BrainOnFire/Wildfire_Detector_Project_Files_Thesis/Wildfire Detector Project PCB Files/Gateway Files/Gateway PCB V1/GatewayPCB.kicad_pcb

## KiCad design Wildfire Detector Project PCB Files/Gateway Files/Gateway PCB V1/GatewayPCB.kicad_pcb (2023-12-11, an earlier design)

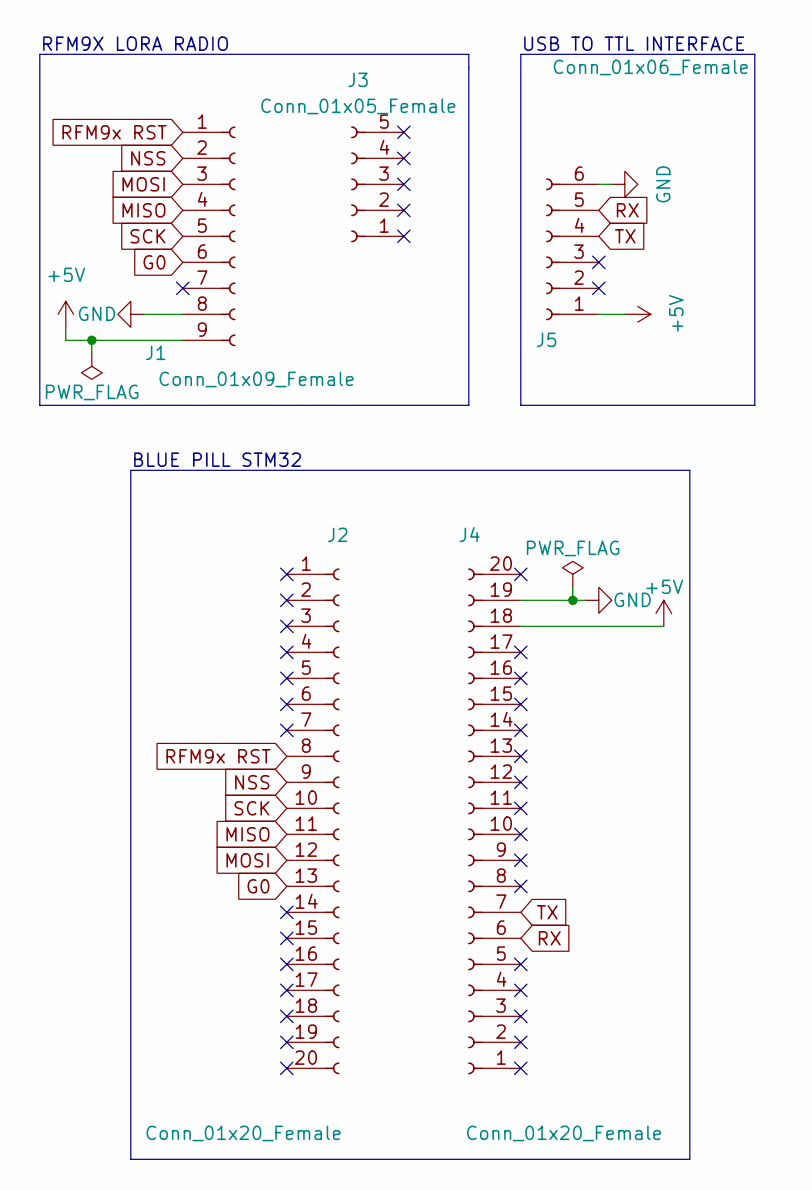
[picture p1: schematic GatewayPCB.kicad_sch, Esquemático de la Puerta de Enlace]

Parts:
J1: Conn_01x09_Female; PinSocket_1x09_P2.54mm_Vertical
J2, J4: Conn_01x20_Female; PinSocket_1x20_P2.54mm_Vertical
J3: Conn_01x05_Female; PinSocket_1x05_P2.54mm_Vertical
J5: Conn_01x06_Female; PinSocket_1x06_P2.54mm_Horizontal

Connections:
+5V: J1.9, J4.18, J5.1
G0: J1.6, J2.13
GND: J1.8, J4.19, J5.6
MISO: J1.4, J2.11
MOSI: J1.3, J2.12
NSS: J1.2, J2.9
RFM9x RST: J1.1, J2.8
RX: J4.6, J5.5
SCK: J1.5, J2.10
TX: J4.7, J5.4

Notes on the sheet:
RFM9X LORA RADIO
USB TO TTL INTERFACE
BLUE PILL STM32

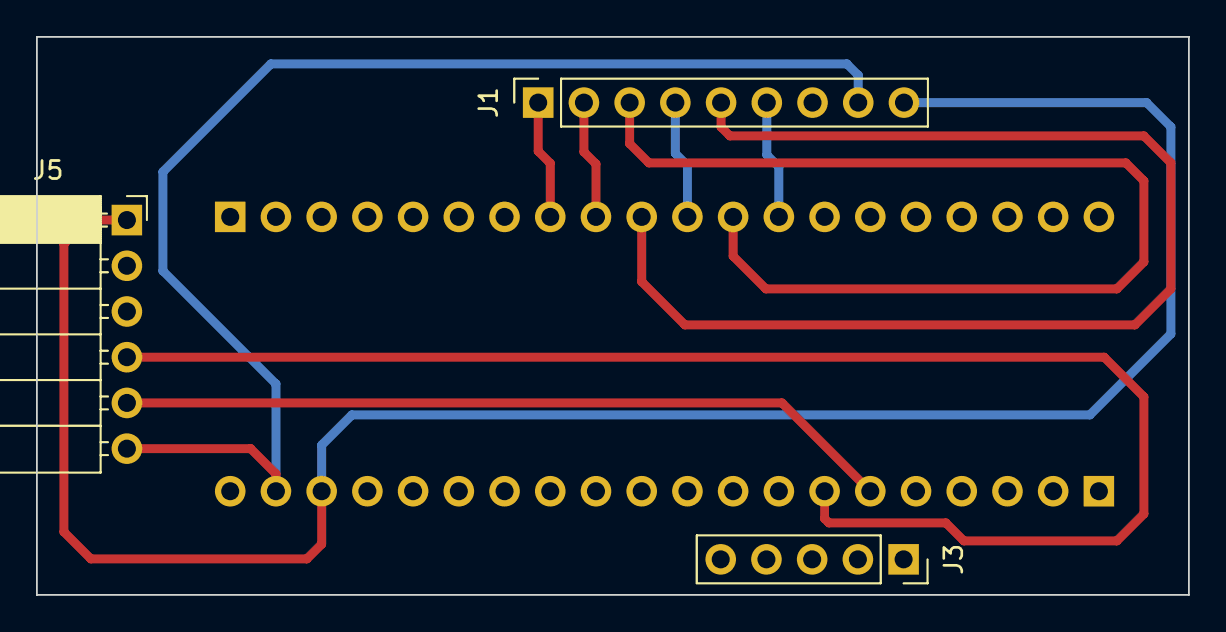
[picture p2: board GatewayPCB.kicad_pcb from above]

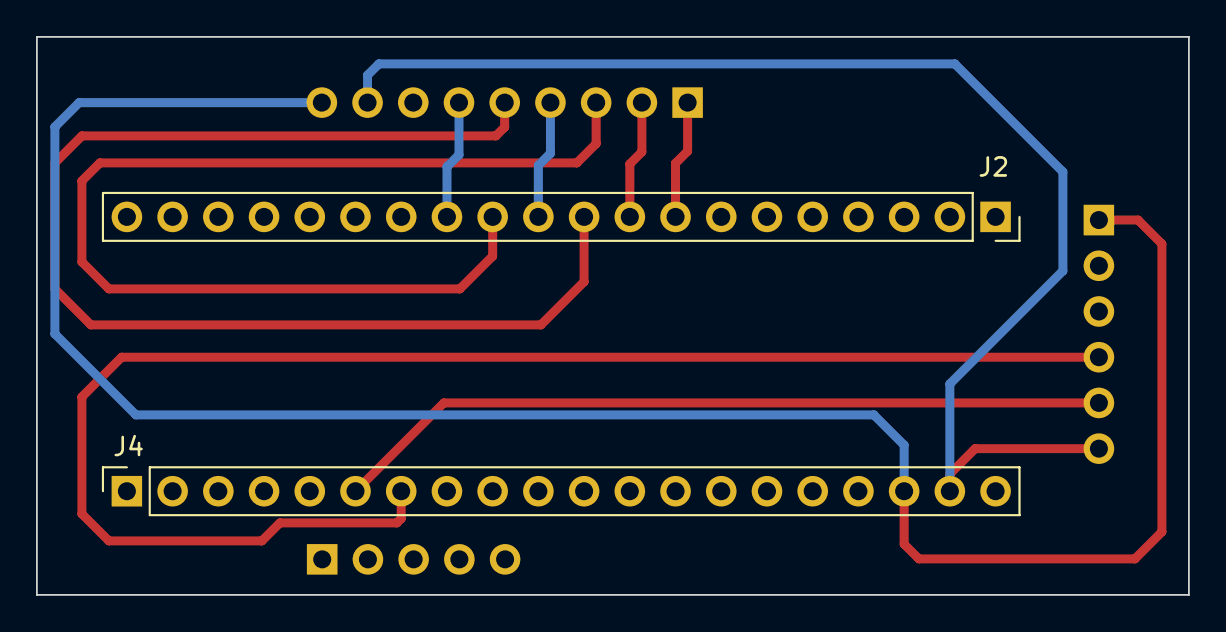
[picture p3: board GatewayPCB.kicad_pcb from below]

Board: 2 copper layers, 64.0 x 31.0 mm, 5 parts (2 on the bottom side), 10 nets.
