BrainOnFire/Wildfire_Detector_Project_Files_Thesis/Wildfire Detector Project PCB Files/Gateway Files/Gateway PCB V2/PCBFiles_Gateway.kicad_pcb

## KiCad design Wildfire Detector Project PCB Files/Gateway Files/Gateway PCB V2/PCBFiles_Gateway.kicad_pcb (2023-12-11)

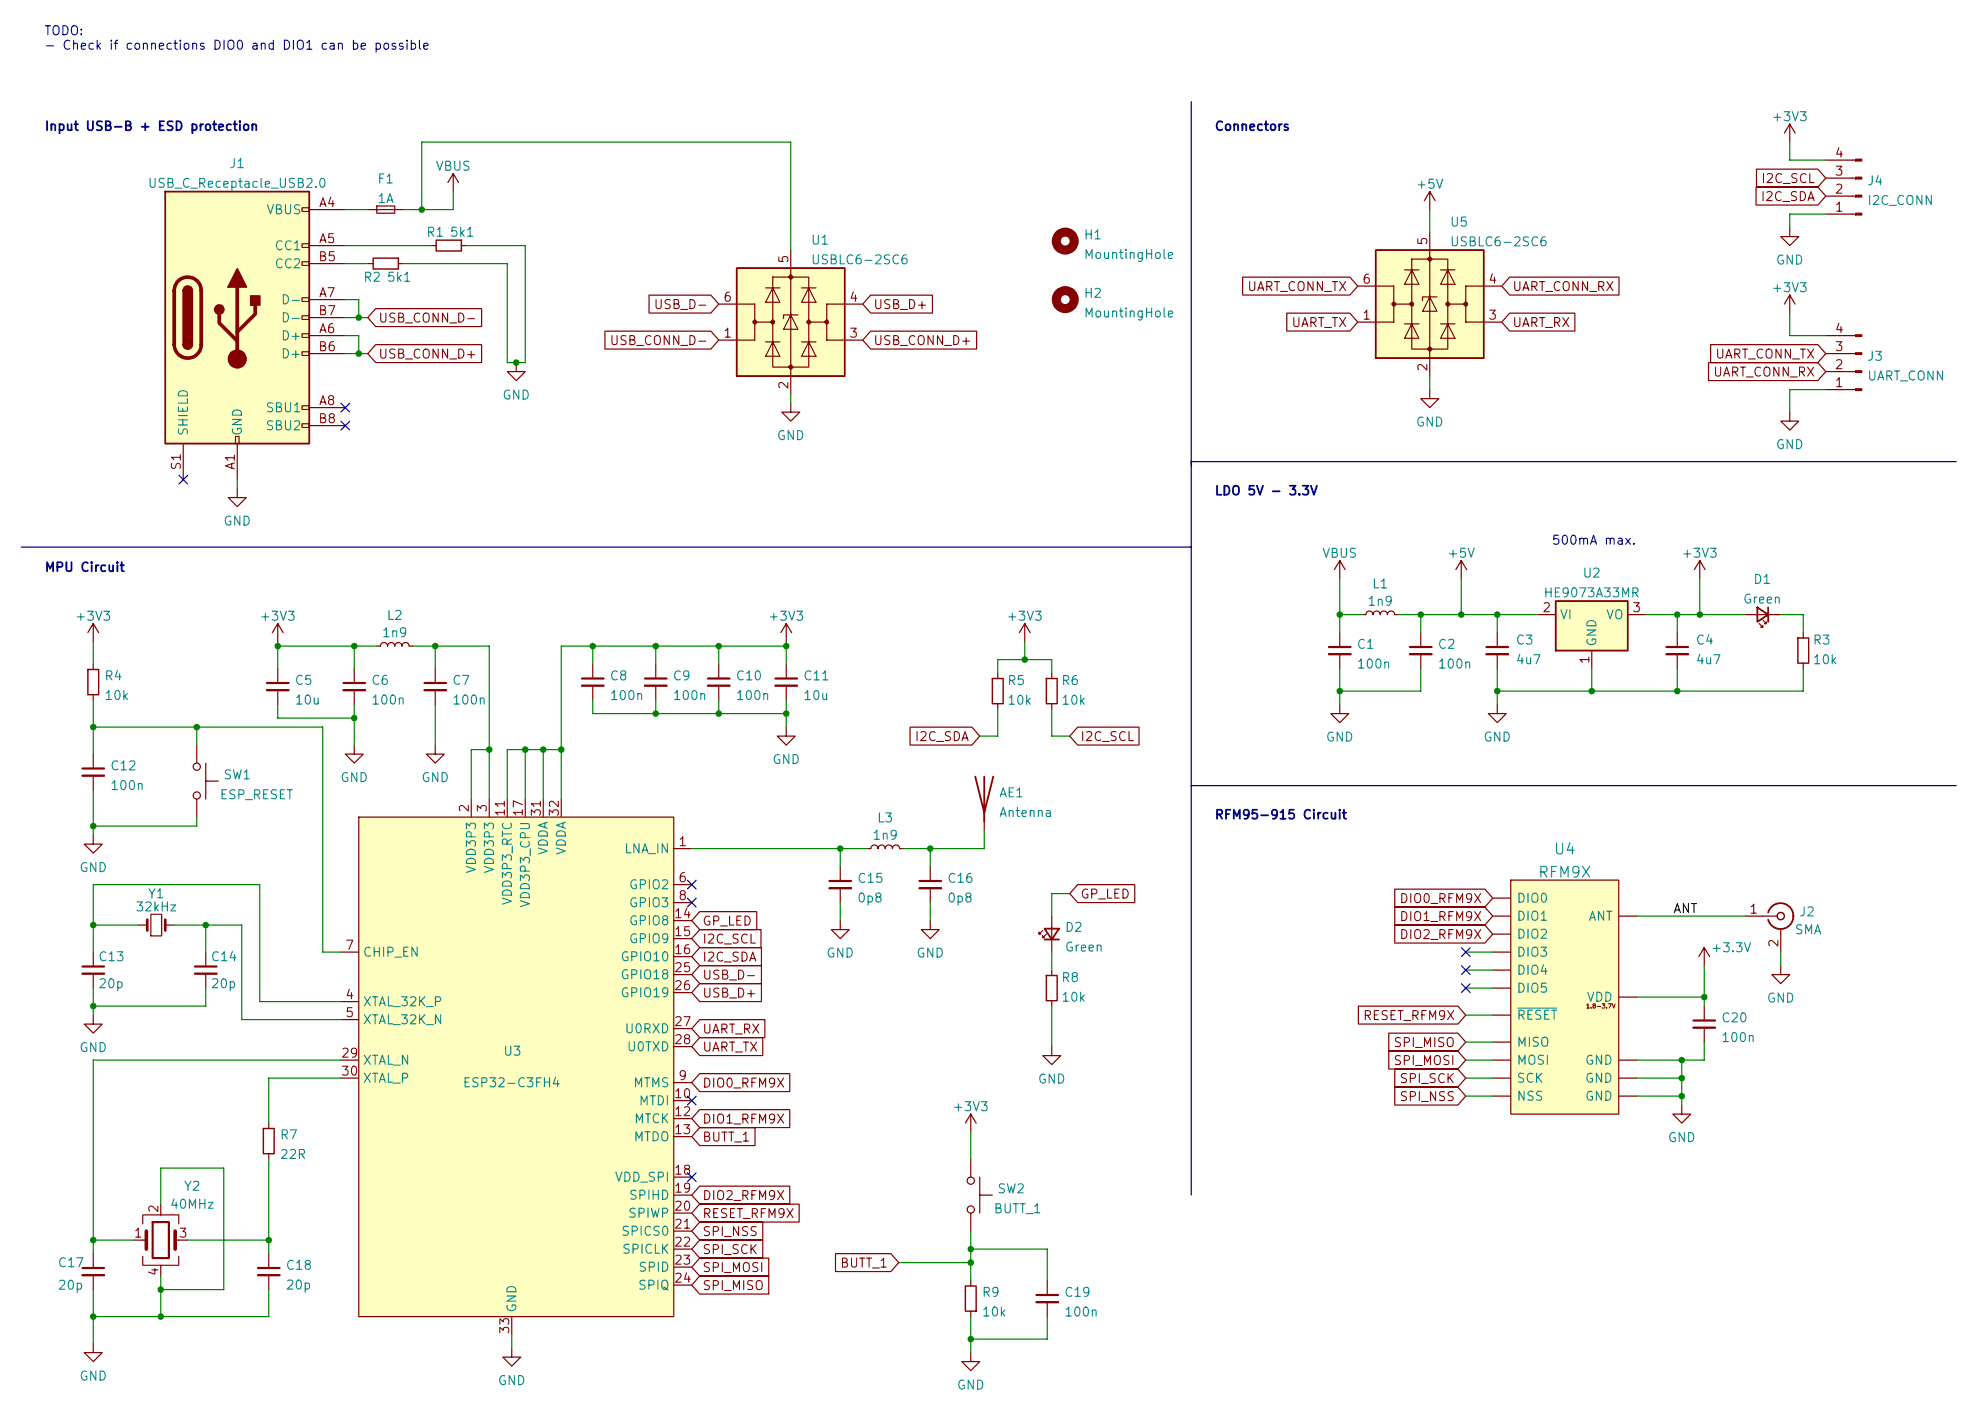
[picture p4: schematic PCBFiles_Gateway.kicad_sch, Gateway PCB Files]

Parts:
AE1: Antenna; PCB Meander Antenna
C1, C2: 100n; C_1206_3216Metric
C3, C4: 4u7; C_1206_3216Metric
C5, C11: 10u; C_0402_1005Metric
C6, C7, C8, C9, C10, C12, C19, C20: 100n; C_0402_1005Metric
C13, C14, C17, C18: 20p; C_0402_1005Metric
C15, C16: 0p8; C_0402_1005Metric
D1, D2: Green; C_0603_1608Metric
F1: 1A; Fuse_0603_1608Metric
H1, H2: MountingHole; MountingHole_2.2mm_M2_Pad
J1: USB_C_Receptacle_USB2.0; USB_C_Receptacle_HRO_TYPE-C-31-M-12
J2: SMA; SMA_Samtec_SMA-J-P-X-ST-EM1_EdgeMount
J3: UART_CONN; Molex_KK-254_AE-6410-04A_1x04_P2.54mm_Vertical
J4: I2C_CONN; PinHeader_1x04_P2.54mm_Vertical
L1, L2, L3: 1n9; L_0402_1005Metric
R1, R2: 5k1; R_0402_1005Metric
R3, R4, R5, R6, R8, R9: 10k; R_0805_2012Metric
R7: 22R; R_0402_1005Metric
SW1: ESP_RESET; SW_SPST_B3U-1000P
SW2: BUTT_1; SW_SPST_B3U-1000P
U1, U5: USBLC6-2SC6; SOT-23-6
U2: HE9073A33MR; SOT-23
U3: ESP32-C3FH4; QFN-32-1EP_5x5mm_P0.5mm_EP3.7x3.7mm
U4: RFM9X; RFM9X-SMD; LCSC Part # C2844473
Y1: 32kHz; Crystal_SMD_3215-2Pin_3.2x1.5mm
Y2: 40MHz; Crystal_SMD_3225-4Pin_3.2x2.5mm

Connections:
+5V: C2.1, C3.1, L1.2, U2.2 (VI), U5.5 (VBUS)
/ANT: J2.1 (In), U4.9 (ANT)
BUTT_1: C19.1, R9.2, SW2.2, U3.13 (MTDO)
DIO0_RFM9X: U3.9 (MTMS), U4.14 (DIO0)
DIO1_RFM9X: U3.12 (MTCK), U4.15 (DIO1)
DIO2_RFM9X: U3.19 (SPIHD), U4.16 (DIO2)
GND: C1.2, C2.2, C3.2, C4.2, C5.2, C6.2, C7.2, C8.2, C9.2, C10.2, C11.2, C12.2, C13.2, C14.2, C15.2, C16.2, C17.2, C18.2, C19.2, C20.2, J1.A1 (GND), J1.A12 (GND), J1.B1 (GND), J1.B12 (GND), J2.2 (Ext), J3.1, J4.1, R1.1, R2.1, R3.2, R8.2, R9.1, SW1.2, U1.2 (GND), U2.1 (GND), U3.33 (GND), U4.1 (GND), U4.8 (GND), U4.10 (GND), U5.2 (GND), Y2.2, Y2.4
GP_LED: D2.2 (A), U3.14 (GPIO8)
I2C_SCL: J4.3, R6.2, U3.15 (GPIO9)
I2C_SDA: J4.2, R5.2, U3.16 (GPIO10)
unnamed: C7.1, L2.2, U3.2 (VDD3P3), U3.3 (VDD3P3)
unnamed: C12.1, R4.2, SW1.1, U3.7 (CHIP_EN)
unnamed: C13.1, U3.4 (XTAL_32K_P), Y1.1
unnamed: C14.1, U3.5 (XTAL_32K_N), Y1.2
unnamed: C15.1, L3.1, U3.1 (LNA_IN)
unnamed: AE1.1 (A), C16.1, L3.2
unnamed: C17.1, U3.29 (XTAL_N), Y2.1
unnamed: C18.1, R7.2, Y2.3
unnamed: D1.1 (K), R3.1
unnamed: D2.1 (K), R8.1
unnamed: F1.1, J1.A4 (VBUS), J1.A9 (VBUS), J1.B4 (VBUS), J1.B9 (VBUS)
unnamed: J1.A5 (CC1), R1.2
unnamed: J1.B5 (CC2), R2.2
unnamed: R7.1, U3.30 (XTAL_P)
RESET_RFM9X: U3.20 (SPIWP), U4.6 (~RESET)
SPI_MISO: U3.24 (SPIQ), U4.2 (MISO)
SPI_MOSI: U3.23 (SPID), U4.3 (MOSI)
SPI_NSS: U3.21 (SPICS0), U4.5 (NSS)
SPI_SCK: U3.22 (SPICLK), U4.4 (SCK)
UART_CONN_RX: J3.2, U5.4 (I/O2)
UART_CONN_TX: J3.3, U5.6 (I/O1)
UART_RX: U3.27 (U0RXD), U5.3 (I/O2)
UART_TX: U3.28 (U0TXD), U5.1 (I/O1)
USB_CONN_D+: J1.A6 (D+), J1.B6 (D+), U1.3 (I/O2)
USB_CONN_D-: J1.A7 (D-), J1.B7 (D-), U1.1 (I/O1)
USB_D+: U1.4 (I/O2), U3.26 (GPIO19)
USB_D-: U1.6 (I/O1), U3.25 (GPIO18)
VBUS: C1.1, F1.2, L1.1, U1.5 (VBUS)

Notes on the sheet:
Connectors
RFM95-915 Circuit
500mA max.
MPU Circuit
TODO: - Check if connections DIO0 and DIO1 can be possible
LDO 5V - 3.3V
Input USB-B + ESD protection

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
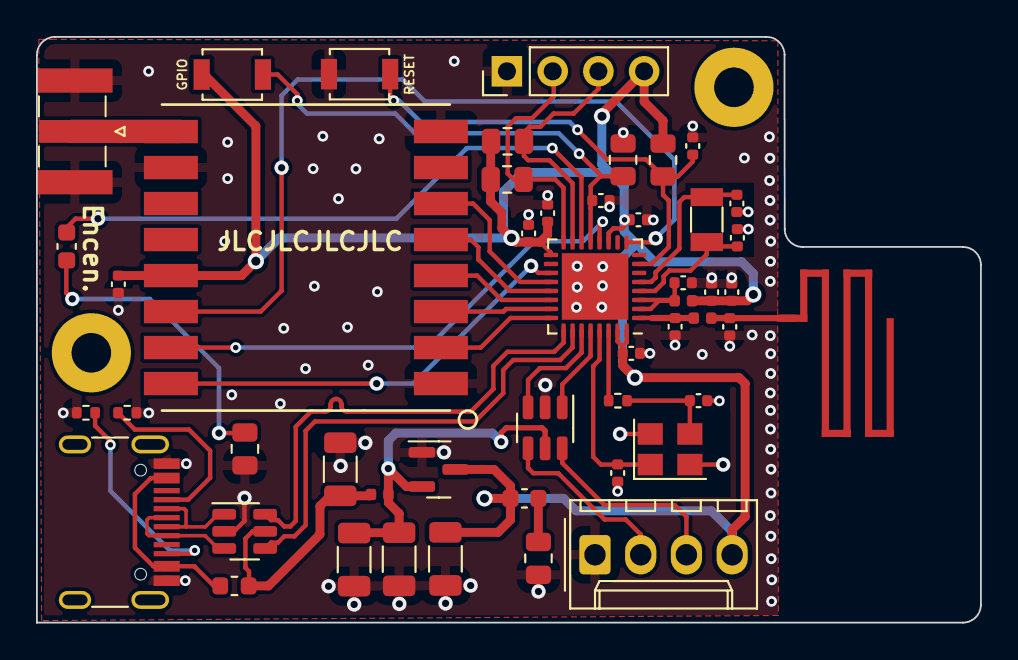
[picture p5: board PCBFiles_Gateway.kicad_pcb from above]

Board: 4 copper layers, 52.4 x 32.5 mm, 51 parts (0 on the bottom side), 39 nets.
