BrainOnFire/Wildfire_Detector_Project_Files_Thesis/Wildfire Detector Project PCB Files/Sensor Node Extension Files/Sensor Node Extra PCB V1/PCBFiles_Node_Extra.kicad_pcb

## KiCad design Wildfire Detector Project PCB Files/Sensor Node Extension Files/Sensor Node Extra PCB V1/PCBFiles_Node_Extra.kicad_pcb (2023-12-11)

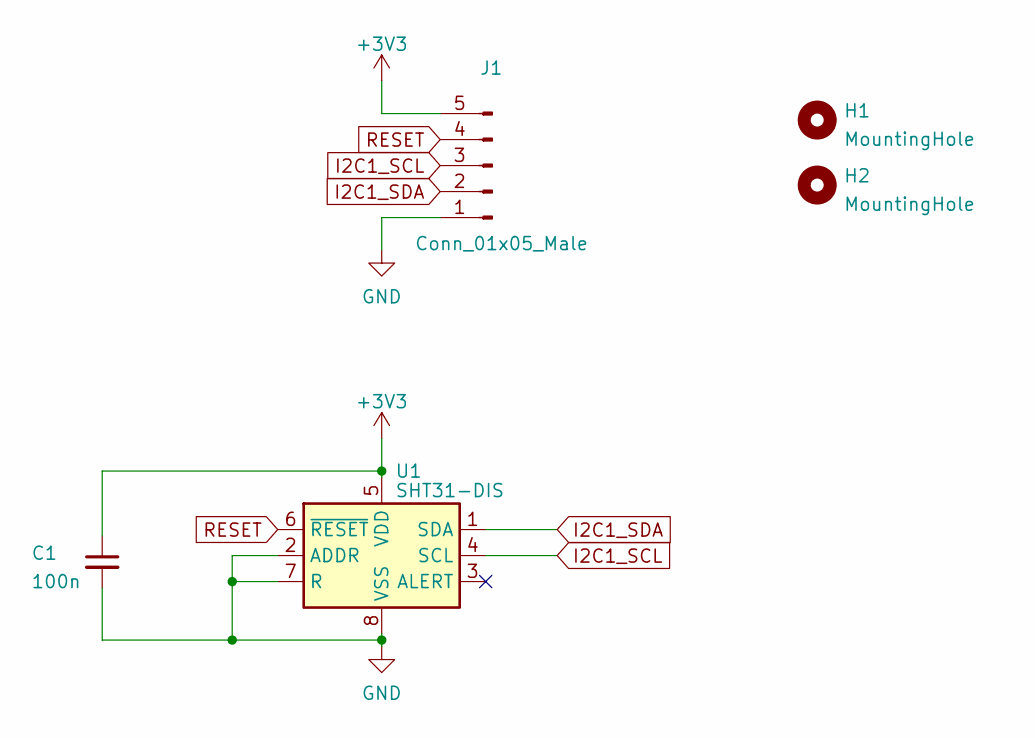
[picture p9: schematic PCBFiles_Node_Extra.kicad_sch]

Parts:
C1: 100n; C_0402_1005Metric; LCSC Part # C307331
H1, H2: MountingHole; MountingHole_2.2mm_M2_Pad
J1: Conn_01x05_Male; PinSocket_1x05_P2.54mm_Vertical
U1: SHT31-DIS; Sensirion_DFN-8-1EP_2.5x2.5mm_P0.5mm_EP1.1x1.7mm

Connections:
+3V3: C1.1, J1.5, U1.5 (VDD)
GND: C1.2, J1.1, U1.2 (ADDR), U1.7 (R), U1.8 (VSS), U1.9 (VSS)
I2C1_SCL: J1.3, U1.4 (SCL)
I2C1_SDA: J1.2, U1.1 (SDA)
RESET: J1.4, U1.6 (~RESET)

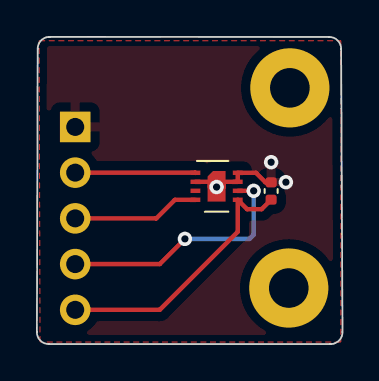
[picture p10: board PCBFiles_Node_Extra.kicad_pcb from above]

Board: 2 copper layers, 17.0 x 17.1 mm, 5 parts (1 on the bottom side), 5 nets.
