BrainOnFire/Wildfire_Detector_Project_Files_Thesis/Wildfire Detector Project PCB Files/Sensor Node Files/Sensor Node PCB V1/NodoSensor.kicad_pcb

## KiCad design Wildfire Detector Project PCB Files/Sensor Node Files/Sensor Node PCB V1/NodoSensor.kicad_pcb (2023-12-11, an earlier design)

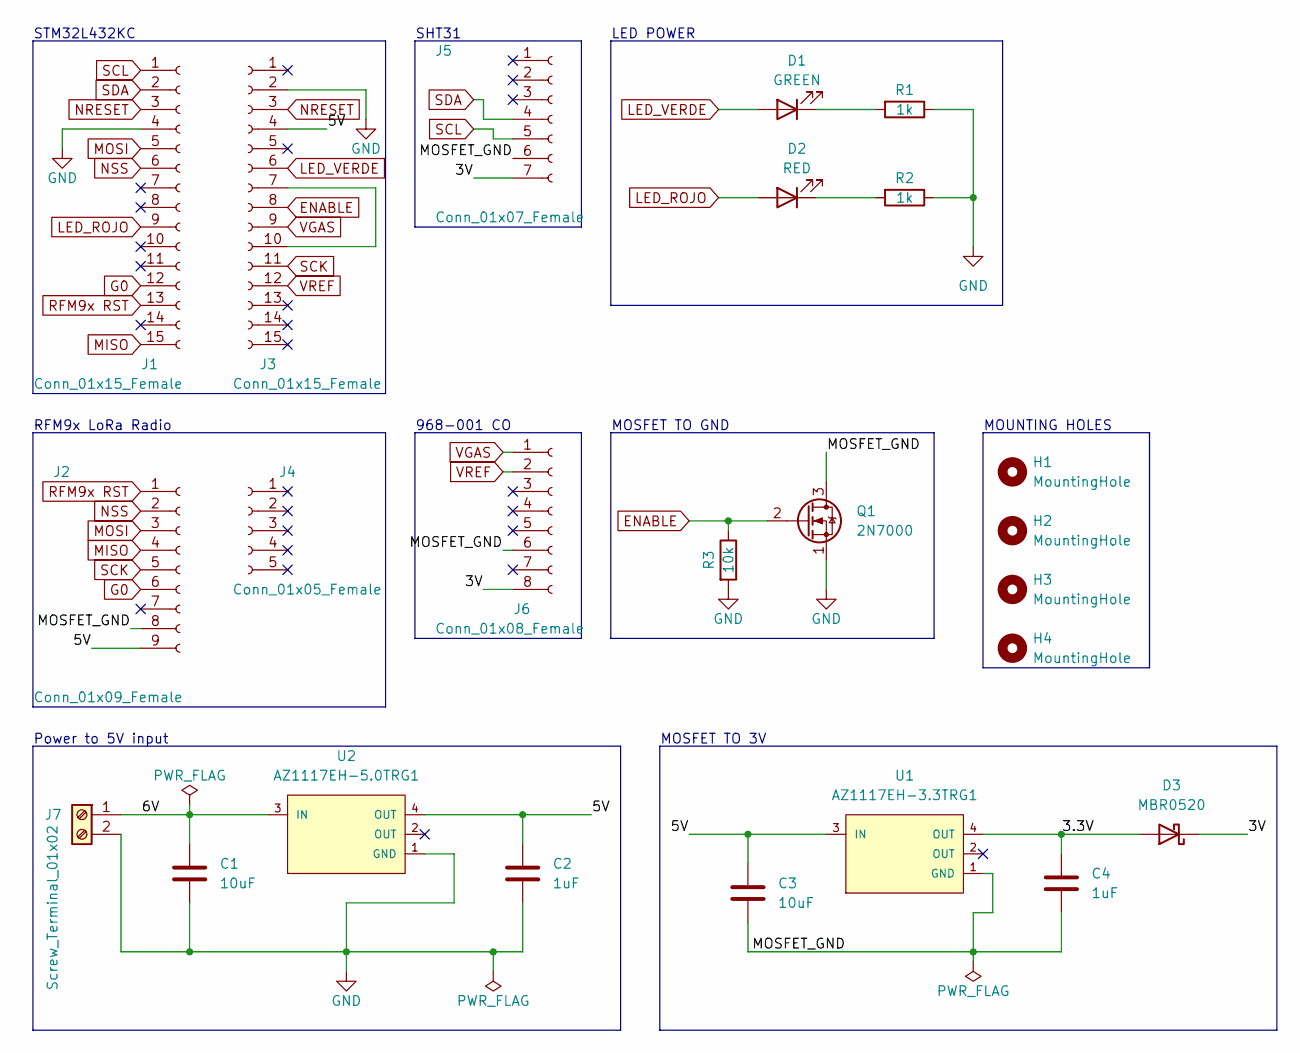
[picture p11: schematic NodoSensor.kicad_sch, Nodo Sensor]

Parts:
C1, C3: 10uF; CP_Radial_D5.0mm_P2.50mm
C2, C4: 1uF; CP_Radial_D5.0mm_P2.50mm
D1: GREEN; LED_D5.0mm
D2: RED; LED_D5.0mm
D3: MBR0520; D_SOD-123
H1, H2, H3, H4: MountingHole; MountingHole_3.2mm_M3
J1, J3: Conn_01x15_Female; PinSocket_1x15_P2.54mm_Vertical
J2: Conn_01x09_Female; PinSocket_1x09_P2.54mm_Vertical
J4: Conn_01x05_Female; PinSocket_1x05_P2.54mm_Vertical
J5: Conn_01x07_Female; PinSocket_1x07_P2.54mm_Vertical
J6: Conn_01x08_Female; PinSocket_1x08_P2.54mm_Vertical
J7: Screw_Terminal_01x02; TerminalBlock_bornier-2_P5.08mm
Q1: 2N7000; TO-92_Inline
R1, R2: 1k; R_Axial_DIN0207_L6.3mm_D2.5mm_P10.16mm_Horizontal
R3: 10k; R_Axial_DIN0207_L6.3mm_D2.5mm_P10.16mm_Horizontal
U1: AZ1117EH-3.3TRG1; SOT230P700X180-4N; PARTREV 3-2
U2: AZ1117EH-5.0TRG1; SOT230P700X180-4N

Connections:
/3.3V: C4.1, D3.2 (A), U1.4 (OUT)
/3V: D3.1 (K), J5.7, J6.8
/5V: C2.1, C3.1, J2.9, J3.4, U1.3 (IN), U2.4 (OUT)
/6V: C1.1, J7.1, U2.3 (IN)
/MOSFET_GND: C3.2, C4.2, J2.8, J5.6, J6.6, Q1.3 (D), U1.1 (GND)
ENABLE: J3.8, Q1.2 (G), R3.1
G0: J1.12, J2.6
GND: C1.2, C2.2, J1.4, J3.2, J7.2, Q1.1 (S), R1.1, R2.1, R3.2, U2.1 (GND)
LED_ROJO: D2.2 (A), J1.9
LED_VERDE: D1.2 (A), J3.6
MISO: J1.15, J2.4
MOSI: J1.5, J2.3
NRESET: J1.3, J3.3
NSS: J1.6, J2.2
unnamed: D1.1 (K), R1.2
unnamed: D2.1 (K), R2.2
unnamed: J3.7, J3.10
RFM9x RST: J1.13, J2.1
SCK: J2.5, J3.11
SCL: J1.1, J5.5
SDA: J1.2, J5.4
VGAS: J3.9, J6.1
VREF: J3.12, J6.2

Notes on the sheet:
SHT31
STM32L432KC
Power to 5V input
MOSFET TO 3V
968-001 CO
MOUNTING HOLES
RFM9x LoRa Radio
LED POWER
MOSFET TO GND

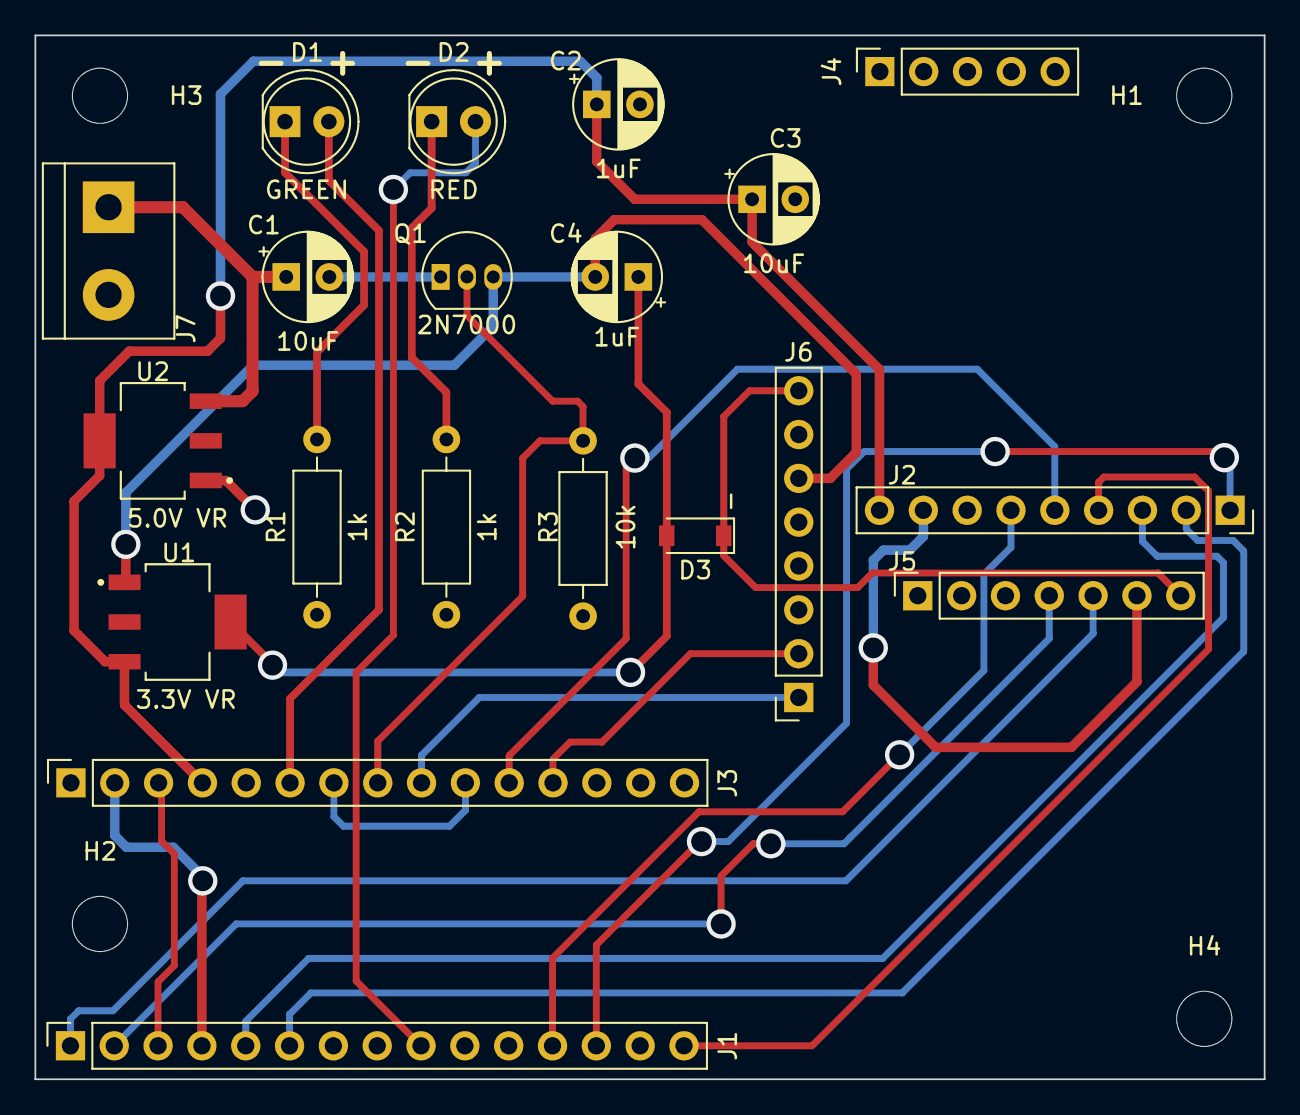
[picture p12: board NodoSensor.kicad_pcb from above]

Board: 2 copper layers, 71.2 x 60.5 mm, 24 parts (0 on the bottom side), 23 nets.
