BrainOnFire/Wildfire_Detector_Project_Files_Thesis/Wildfire Detector Project Code Files/Gateway Files/Gateway Code V1/Core/Src/main.c

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
/* Includes ------------------------------------------------------------------*/
#include "main.h"

/* USER CODE BEGIN Includes */
#include <stdbool.h>
#include <string.h>
#include <stdio.h>
#include "rfm95.h"
/* USER CODE END Includes */

SPI_HandleTypeDef hspi1;

UART_HandleTypeDef huart1;

/* USER CODE BEGIN PV */
uint8_t buf[50];
uint8_t uart_buf[50];
uint8_t temp, hum, monoxido_temp1, monoxido_temp2;
uint8_t verificador1, verificador2;
uint16_t CO;
int RSSI = 0;
float SNR = 0;
uint8_t contador = 0;

rfm95_handle_t rfm95_handle = {
    .spi_handle = &hspi1,
    .nss_port = SPI1_NSS_GPIO_Port,
    .nss_pin = SPI1_NSS_Pin,
    .nrst_port = RESET_GPIO_Port,
    .nrst_pin = RESET_Pin,
};
/* USER CODE END PV */

void SystemClock_Config(void);
static void MX_GPIO_Init(void);
static void MX_SPI1_Init(void);
static void MX_USART1_UART_Init(void);
/* USER CODE BEGIN PFP */
void umbral_temperatura(uint8_t temperatura);
void umbral_humedad(uint8_t humedad);
void umbral_monoxido(uint16_t monoxido);
void contador_update(void);
/* USER CODE END PFP */

/**
  * @brief  The application entry point.
  * @retval int
  */
int main(void)
{
  /* MCU Configuration--------------------------------------------------------*/

  /* Reset of all peripherals, Initializes the Flash interface and the Systick. */
  HAL_Init();

  /* Configure the system clock */
  SystemClock_Config();

  /* Initialize all configured peripherals */
  MX_GPIO_Init();
  MX_SPI1_Init();
  MX_USART1_UART_Init();
  /* USER CODE BEGIN 2 */
  do{
	  //Inicializar modulo LoRa
	  if(rfm95_init(&rfm95_handle)){
		  HAL_GPIO_WritePin(LED_GPIO_Port, LED_Pin, GPIO_PIN_RESET);
		  HAL_GPIO_WritePin(LED_GPIO_Port, LED_Pin, GPIO_PIN_SET);
		  sprintf((char*)uart_buf, "Modulo LoRa Inicializado\n");
		  HAL_UART_Transmit(&huart1, uart_buf, strlen((char*)uart_buf), HAL_MAX_DELAY);
		  verificador1 = 1;
		  verificador2 = 1;
	  }
	  else{
		  rfm95_reset(&rfm95_handle);
	  }
  }
  while(!verificador1);
  /* USER CODE END 2 */

  /* Infinite loop */
  /* USER CODE BEGIN WHILE */
  while (verificador2 == 1)
  {
	  // Recibir los datos por LoRa
	  rfm95_receive_package(&rfm95_handle, &temp, &hum, &monoxido_temp1, &monoxido_temp2, RSSI, SNR);
	  // Validation message
	  CO = (monoxido_temp1 << 8) | monoxido_temp2;
	  sprintf((char*)uart_buf, "Conexion exitosa\n");
	  HAL_UART_Transmit(&huart1, uart_buf, strlen((char*)uart_buf), HAL_MAX_DELAY);

	  //Comparacion de los datos con umbrales
	  umbral_temperatura(temp);
	  umbral_humedad(hum);
	  umbral_monoxido(CO);
	  contador_update();
	  //sprintf((char*)uart_buf, "Temperatura: %u C, Humedad: %u HR, %u PPM \n", temp, hum, CO);
	  //HAL_UART_Transmit(&huart1, uart_buf, strlen((char*)uart_buf), HAL_MAX_DELAY);
	  //sprintf((char*)uart_buf, "SNR: %.2f C, RSSI: %i  \n", SNR, RSSI);
	  //HAL_UART_Transmit(&huart1, uart_buf, strlen((char*)uart_buf), HAL_MAX_DELAY);
	  temp = 0;
	  hum = 0;
	  CO = 0;
	  monoxido_temp1 = 0;
	  monoxido_temp2 = 0;
	  contador = 0;
    /* USER CODE END WHILE */

    /* USER CODE BEGIN 3 */
  }
  /* USER CODE END 3 */
}

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
/* USER CODE BEGIN 4 */
void umbral_temperatura(uint8_t temperatura){
	//Comparacion temperatura
	if(37 < temperatura && temperatura < 80){
		sprintf((char*)uart_buf, "Atencion!! Temperatura muy Alta\n");
		HAL_UART_Transmit(&huart1, uart_buf, strlen((char*)uart_buf), HAL_MAX_DELAY);
		contador++;
	}
	else if(temperatura < 10 || temperatura > 80){
		sprintf((char*)uart_buf, "Atencion!! Valor erroneo de temperatura\n");
		HAL_UART_Transmit(&huart1, uart_buf, strlen((char*)uart_buf), HAL_MAX_DELAY);
	}

	else if(10 < temperatura && temperatura < 37){
		sprintf((char*)uart_buf, "Valores normales de temperatura\n");
		HAL_UART_Transmit(&huart1, uart_buf, strlen((char*)uart_buf), HAL_MAX_DELAY);
	}
	sprintf((char*)uart_buf, "Temperatura = %u C\n", temperatura);
	HAL_UART_Transmit(&huart1, uart_buf, strlen((char*)uart_buf), HAL_MAX_DELAY);
}

void umbral_humedad(uint8_t humedad){
	if(5 < humedad && humedad < 20){
		sprintf((char*)uart_buf, "Atencion!! Humedad muy baja\n");
		HAL_UART_Transmit(&huart1, uart_buf, strlen((char*)uart_buf), HAL_MAX_DELAY);
		contador++;
	}
	else if(humedad < 5 || humedad > 95){
		sprintf((char*)uart_buf, "Atencion!! Valor erroneo de humedad\n");
		HAL_UART_Transmit(&huart1, uart_buf, strlen((char*)uart_buf), HAL_MAX_DELAY);
	}
	else if(20 < humedad && humedad < 95){
		sprintf((char*)uart_buf, "Valores normales de humedad\n");
		HAL_UART_Transmit(&huart1, uart_buf, strlen((char*)uart_buf), HAL_MAX_DELAY);
	}
	sprintf((char*)uart_buf, "Humedad = %u HR\n", humedad);
	HAL_UART_Transmit(&huart1, uart_buf, strlen((char*)uart_buf), HAL_MAX_DELAY);
}

void umbral_monoxido(uint16_t monoxido){
	if(800 < monoxido && monoxido < 7000){
		sprintf((char*)uart_buf, "Atencion!! Valores de CO muy altos\n");
		HAL_UART_Transmit(&huart1, uart_buf, strlen((char*)uart_buf), HAL_MAX_DELAY);
		contador += 2;
	}
	else if(monoxido > 7000){
		sprintf((char*)uart_buf, "Atencion!! Valor erroneos de CO\n");
		HAL_UART_Transmit(&huart1, uart_buf, strlen((char*)uart_buf), HAL_MAX_DELAY);
	}
	else if(0 <= monoxido && monoxido < 800){
		sprintf((char*)uart_buf, "Valores normales de CO\n");
		HAL_UART_Transmit(&huart1, uart_buf, strlen((char*)uart_buf), HAL_MAX_DELAY);
	}
	sprintf((char*)uart_buf, "CO = %u PPM\n", monoxido);
	HAL_UART_Transmit(&huart1, uart_buf, strlen((char*)uart_buf), HAL_MAX_DELAY);
}

void contador_update(void){
	switch(contador){
	case 1:
		sprintf((char*)uart_buf, "Existe un bajo riesgo de incendio\n");
		HAL_UART_Transmit(&huart1, uart_buf, strlen((char*)uart_buf), HAL_MAX_DELAY);
		break;
	case 2:
		sprintf((char*)uart_buf, "Alerta! Existe un riesgo medio de incendio.\n");
		HAL_UART_Transmit(&huart1, uart_buf, strlen((char*)uart_buf), HAL_MAX_DELAY);
		break;
	case 4:
		sprintf((char*)uart_buf, "Alerta!! Existe un alto riesgo de incendio.\n");
		HAL_UART_Transmit(&huart1, uart_buf, strlen((char*)uart_buf), HAL_MAX_DELAY);
		break;
	default:
		sprintf((char*)uart_buf, "No existe riesgo de incendio.\n");
		HAL_UART_Transmit(&huart1, uart_buf, strlen((char*)uart_buf), HAL_MAX_DELAY);
	}
}
/* USER CODE END 4 */
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
