BrainOnFire/Wildfire_Detector_Project_Files_Thesis/Wildfire Detector Project Code Files/Sensor Node Files/Sensor Node Code V3.1/Core/Inc/main.h

#define V_REF_IN_Pin GPIO_PIN_0
#define V_REF_IN_GPIO_Port GPIOA
#define V_REF_OUT_Pin GPIO_PIN_3
#define V_REF_OUT_GPIO_Port GPIOA
#define V_GAS_Pin GPIO_PIN_6
#define V_GAS_GPIO_Port GPIOA
#define V_REF_OUT_IN_Pin GPIO_PIN_7
#define V_REF_OUT_IN_GPIO_Port GPIOA
#define LED_ROJO_Pin GPIO_PIN_6
#define LED_ROJO_GPIO_Port GPIOC
#define LED_VERDE_Pin GPIO_PIN_7
#define LED_VERDE_GPIO_Port GPIOC
#define RESET_SHT31_Pin GPIO_PIN_8
#define RESET_SHT31_GPIO_Port GPIOA
#define SWDIO_Pin GPIO_PIN_13
#define SWDIO_GPIO_Port GPIOA
#define SWCLK_Pin GPIO_PIN_14
#define SWCLK_GPIO_Port GPIOA
#define RESET_RFM9X_Pin GPIO_PIN_15
#define RESET_RFM9X_GPIO_Port GPIOA
#define SPI3_NSS_Pin GPIO_PIN_2
#define SPI3_NSS_GPIO_Port GPIOD
#define DIO0_RFM9X_Pin GPIO_PIN_4
#define DIO0_RFM9X_GPIO_Port GPIOB
#define BATT_IND_Pin GPIO_PIN_5
#define BATT_IND_GPIO_Port GPIOB
