BrainOnFire/Wildfire_Detector_Project_Files_Thesis/Wildfire Detector Project Code Files/Sensor Node Files/Sensor Node Code V3.1/Core/Src/main.c

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
/* Includes ------------------------------------------------------------------*/
#include "main.h"

/* USER CODE BEGIN Includes */
#include <stdbool.h>
#include <string.h>
#include <stdio.h>
#include "sht3x.h"
#include "rfm95.h"
/* USER CODE END Includes */

ADC_HandleTypeDef hadc1;

I2C_HandleTypeDef hi2c1;

UART_HandleTypeDef hlpuart1;

OPAMP_HandleTypeDef hopamp1;

RTC_HandleTypeDef hrtc;

SPI_HandleTypeDef hspi3;

/* USER CODE BEGIN PV */
uint8_t uart_buf[65];
uint16_t monoxido;
uint8_t lora_buf[4]; //Cambio de uint16_t --> uint8_t
uint8_t temp, hum, verificador1, verificador2, enviado, monoxido_temp1, monoxido_temp2;
uint8_t V_OFFSET = 0;				// Cambiar en caso se requiera calibrar
uint16_t V_REF;
uint16_t V_GAS;
uint16_t value[2];
const float calibFactor = 1.90071;	// Calibration Factor -> SensitivityCode * TIAGain * 10^-9 * 10^3 -> 0.000406 -> ((1/0.000406)*(3.14/4096)) = 1.90071

sht3x_handle_t sht3x_handle = {
    .i2c_handle = &hi2c1,
    .device_address = SHT3X_I2C_DEVICE_ADDRESS_ADDR_PIN_LOW
};

rfm95_handle_t rfm95_handle = {
    .spi_handle = &hspi3,
    .nss_port = SPI3_NSS_GPIO_Port,
    .nss_pin = SPI3_NSS_Pin,
    .nrst_port = RESET_RFM9X_GPIO_Port,
    .nrst_pin = RESET_RFM9X_Pin,
    .irq_port = GPIOC,
    //.irq_pin = G0_LORA_INT_Pin
};
/* USER CODE END PV */

void SystemClock_Config(void);
static void MX_GPIO_Init(void);
static void MX_ADC1_Init(void);
static void MX_I2C1_Init(void);
static void MX_RTC_Init(void);
static void MX_OPAMP1_Init(void);
static void MX_SPI3_Init(void);
static void MX_LPUART1_UART_Init(void);
/* USER CODE BEGIN PFP */
void Sleep_Mode_Node(void);
void HAL_ADC_CHANNEL_11(void);
void HAL_ADC_CHANNEL_9(void);
bool CO(uint16_t *targetGas);
/* USER CODE END PFP */

/**
  * @brief  The application entry point.
  * @retval int
  */
int main(void)
{
  /* MCU Configuration--------------------------------------------------------*/

  /* Reset of all peripherals, Initializes the Flash interface and the Systick. */
  HAL_Init();

  /* Configure the system clock */
  SystemClock_Config();

  /* Initialize all configured peripherals */
  MX_GPIO_Init();
  MX_ADC1_Init();
  MX_I2C1_Init();
  MX_RTC_Init();
  MX_OPAMP1_Init();
  MX_SPI3_Init();
  MX_LPUART1_UART_Init();
  /* USER CODE BEGIN 2 */
  do{
	  //Inicializar modulo LoRa
	  if(rfm95_init(&rfm95_handle)){
		  //sprintf((char*)uart_buf, "Modulo LoRa inicializado exitosamente\n\r");
		  //HAL_UART_Transmit(&huart2, uart_buf, strlen((char*)uart_buf), HAL_MAX_DELAY);
		  verificador1 = 1;
		  verificador2 = 1;
		  if(sht3x_init(&sht3x_handle)){
			  //Encender LED Verde
			  HAL_GPIO_WritePin(LED_VERDE_GPIO_Port, LED_VERDE_Pin, GPIO_PIN_SET);
			  //sprintf((char*)uart_buf, "Sensor de temperatura y humedad inicializado existosamente\n\r");
			  //HAL_UART_Transmit(&huart2, uart_buf, strlen((char*)uart_buf), HAL_MAX_DELAY);
			  }
 	  }
 	  else{
 		  // Encender LED Rojo veces
 		  HAL_GPIO_WritePin(GPIOB, LED_ROJO_Pin, GPIO_PIN_SET);
 		  // Esperar 0.5 segundos
 		  HAL_Delay(1500);
 		  //HAL_GPIO_WritePin(RESET_GPIO_Port, RESET_Pin, GPIO_PIN_RESET);
 		  // 0.1ms would theoretically be enough
 		  HAL_Delay(1);
 		  HAL_GPIO_WritePin(RESET_RFM9X_GPIO_Port, RESET_RFM9X_Pin, GPIO_PIN_SET);
 		  HAL_Delay(5);
 		  HAL_GPIO_WritePin(GPIOB, LED_ROJO_Pin, GPIO_PIN_RESET);
 	  }
   }
   while(!verificador1);

  /* Verificar si la bandera SB esta limpia */
  if (__HAL_PWR_GET_FLAG(PWR_FLAG_SB) != RESET)
  {
	  /* Limpiar la bandera PWR */
	  __HAL_PWR_CLEAR_FLAG(PWR_FLAG_SB);

	  /* Desactivar el timer por RTC */
	  HAL_RTCEx_DeactivateWakeUpTimer(&hrtc);
  }
  /* USER CODE END 2 */

  /* Infinite loop */
  /* USER CODE BEGIN WHILE */
  while (verificador2)
  {
	  // Lectura de temperatura y humedad
	  sht3x_read_temperature_and_humidity(&sht3x_handle, &lora_buf[0], &lora_buf[1]);

	  // Lectura del valor de CO
	  HAL_ADC_Start_DMA(&hadc1, (uint32_t*) value, 2);
	  CO(&monoxido);

	  monoxido_temp1 = monoxido >> 8;   //MSB
	  monoxido_temp2 = monoxido & 0xFF;	//LSB

	  lora_buf[2] = monoxido_temp1;
	  lora_buf[3] = monoxido_temp2;

	  //sprintf((char*)uart_buf, "Temperatura: %u C, Humedad: %u%% HR\n\r", lora_buf[0], lora_buf[1]);
	  //HAL_UART_Transmit(&huart2, uart_buf, strlen((char*)uart_buf), HAL_MAX_DELAY);

	  //sprintf((char*)uart_buf, "Particulas por Millon de CO %u PPM\n\r", monoxido);
	  //HAL_UART_Transmit(&huart2, uart_buf, strlen((char*)uart_buf), HAL_MAX_DELAY);

	  // Enviar temperatura
	  rfm95_send_package(&rfm95_handle, lora_buf, sizeof(lora_buf), enviado);
	  //sprintf((char*)uart_buf, "Envío correcto de datos\n\r");
	  //HAL_UART_Transmit(&huart2, uart_buf, strlen((char*)uart_buf), HAL_MAX_DELAY);

	  HAL_GPIO_WritePin(GPIOA, LED_VERDE_Pin, GPIO_PIN_RESET);

	  //HAL_Delay(1000);
	  Sleep_Mode_Node();
    /* USER CODE END WHILE */

    /* USER CODE BEGIN 3 */
  }
  /* USER CODE END 3 */
}

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
/* USER CODE BEGIN 4 */
void Sleep_Mode_Node(void){
	//Abrir el circuito del transistor (LoRa enable)
	//HAL_GPIO_WritePin(ENABLE_GPIO_Port, ENABLE_Pin, GPIO_PIN_RESET);

	/* Limpiar la bandera WU */
	__HAL_PWR_CLEAR_FLAG(PWR_FLAG_WU);

	/* Limpiar la bandera de WUTF */
	__HAL_RTC_WAKEUPTIMER_CLEAR_FLAG(&hrtc, RTC_FLAG_WUTF);

	/* Activar la interrupcion por RTC */
	if(HAL_RTCEx_SetWakeUpTimer_IT(&hrtc, 5, RTC_WAKEUPCLOCK_CK_SPRE_16BITS) != HAL_OK){
	  Error_Handler();
	}

	/* Enviar el comando Sleep al modulo LoRa */
	//sprintf((char*)uart_buf, "Entrando en modo Stand-By por 30 segundos\n\r");
	//HAL_UART_Transmit(&huart2, uart_buf, strlen((char*)uart_buf), HAL_MAX_DELAY);

	/* Entrar a modo Stand-By */
	HAL_PWR_EnterSTANDBYMode();
}

bool CO(uint16_t *targetGas){

	// Encender el ADC1_CHANNEL_11
	//HAL_ADC_CHANNEL_11();
	// Obtener el valor de Vref
	V_GAS = value[0]; // Channel 11
	V_REF = value[1]; // Channel 8
	//HAL_ADC_Stop(&hadc1);

	//float V_REF_TEMP = 0;
	//float V_GAS_TEMP = 0;

	//V_REF_TEMP = (3.1/2048)*V_REF;
	//V_GAS_TEMP = (3.1/2048)*V_GAS;
	// Encender el ADC1_CHANNEL_9
	//HAL_ADC_CHANNEL_9();
	//HAL_ADC_Start(&hadc1);
	//HAL_ADC_PollForConversion(&hadc1, HAL_MAX_DELAY);
	// Obtener el valor de Vgas
	//V_GAS = HAL_ADC_GetValue(&hadc1); // Channel 9

	// Obtener el valor del gas segun el calculo del datasheet
	*targetGas = calibFactor*(V_GAS - (V_REF + V_OFFSET)); // Cx = 1/M * (Vgas - (Vref + Voffset))
	// Terminar la lectura del ADC para no desperdiciar recursos
	//HAL_ADC_Stop(&hadc1);
	HAL_ADC_Stop_DMA(&hadc1);

	return true;
}
/* USER CODE END 4 */
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
