BrainOnFire/Wildfire_Detector_Project_Files_Thesis/Wildfire Detector Project Code Files/Gateway Files/Gateway Code V1/RFM95_Library/Inc/rfm95.h

#pragma once

#include <stdbool.h>

#include "stm32f1xx_hal.h"
#if (defined STM32L011xx) || (defined STM32L021xx) || \
	(defined STM32L031xx) || (defined STM32L041xx) || \
	(defined STM32L051xx) || (defined STM32L052xx) || (defined STM32L053xx) || \
	(defined STM32L061xx) || (defined STM32L062xx) || (defined STM32L063xx) || \
	(defined STM32L071xx) || (defined STM32L072xx) || (defined STM32L073xx) || \
	(defined STM32L081xx) || (defined STM32L082xx) || (defined STM32L083xx)
#include "stm32l0xx_hal.h"
#elif defined (STM32L412xx) || defined (STM32L422xx) || \
	defined (STM32L431xx) || (defined STM32L432xx) || defined (STM32L433xx) || defined (STM32L442xx) || defined (STM32L443xx) || \
	defined (STM32L451xx) || defined (STM32L452xx) || defined (STM32L462xx) || \
	defined (STM32L471xx) || defined (STM32L475xx) || defined (STM32L476xx) || defined (STM32L485xx) || defined (STM32L486xx) || \
    defined (STM32L496xx) || defined (STM32L4A6xx) || \
    defined (STM32L4R5xx) || defined (STM32L4R7xx) || defined (STM32L4R9xx) || defined (STM32L4S5xx) || defined (STM32L4S7xx) || defined (STM32L4S9xx)
#include "stm32l4xx_hal.h"
#elif defined (STM32F405xx) || defined (STM32F415xx) || defined (STM32F407xx) || defined (STM32F417xx) || \
    defined (STM32F427xx) || defined (STM32F437xx) || defined (STM32F429xx) || defined (STM32F439xx) || \
    defined (STM32F401xC) || defined (STM32F401xE) || defined (STM32F410Tx) || defined (STM32F410Cx) || \
    defined (STM32F410Rx) || defined (STM32F411xE) || defined (STM32F446xx) || defined (STM32F469xx) || \
    defined (STM32F479xx) || defined (STM32F412Cx) || defined (STM32F412Rx) || defined (STM32F412Vx) || \
    defined (STM32F412Zx) || defined (STM32F413xx) || defined (STM32F423xx)
#include "stm32f4xx_hal.h"
#endif

#ifndef RFM95_SPI_TIMEOUT
#define RFM95_SPI_TIMEOUT 10
#endif

/**
 * Structure defining a handle describing am RFM95(W) transceiver.
 */
typedef struct {

	/**
	 * The handle to the SPI bus for the device.
	 */
	SPI_HandleTypeDef *spi_handle;

	/**
	 * The port of the NSS pin.
	 */
	GPIO_TypeDef *nss_port;

	/**
	 * The NSS pin.
	 */
	uint16_t nss_pin;

	/**
	 * The port of the RST pin.
	 */
	GPIO_TypeDef *nrst_port;

	/**
	 * The RST pin.
	 */
	uint16_t nrst_pin;

} rfm95_handle_t;

bool rfm95_init(rfm95_handle_t *handle);

void rfm95_reset(rfm95_handle_t *handle);

bool rfm95_set_power(rfm95_handle_t *handle, int8_t power);

bool rfm95_receive_package(rfm95_handle_t *handle, uint8_t *data, uint8_t *data2, uint8_t *data3, uint8_t *data4, int RSSI, float SNR);
