BrainOnFire/Wildfire_Detector_Project_Files_Thesis/(notices)

Notices in the files:
Wildfire Detector Project Code Files/Gateway Files/Gateway Code V1/Core/Src/main.c:
Copyright (c) 2022 STMicroelectronics.
All rights reserved.
This software is licensed under terms that can be found in the LICENSE file
